jtdevs/LIDAR/user manual/img/IMG_20170323_115832.jpg

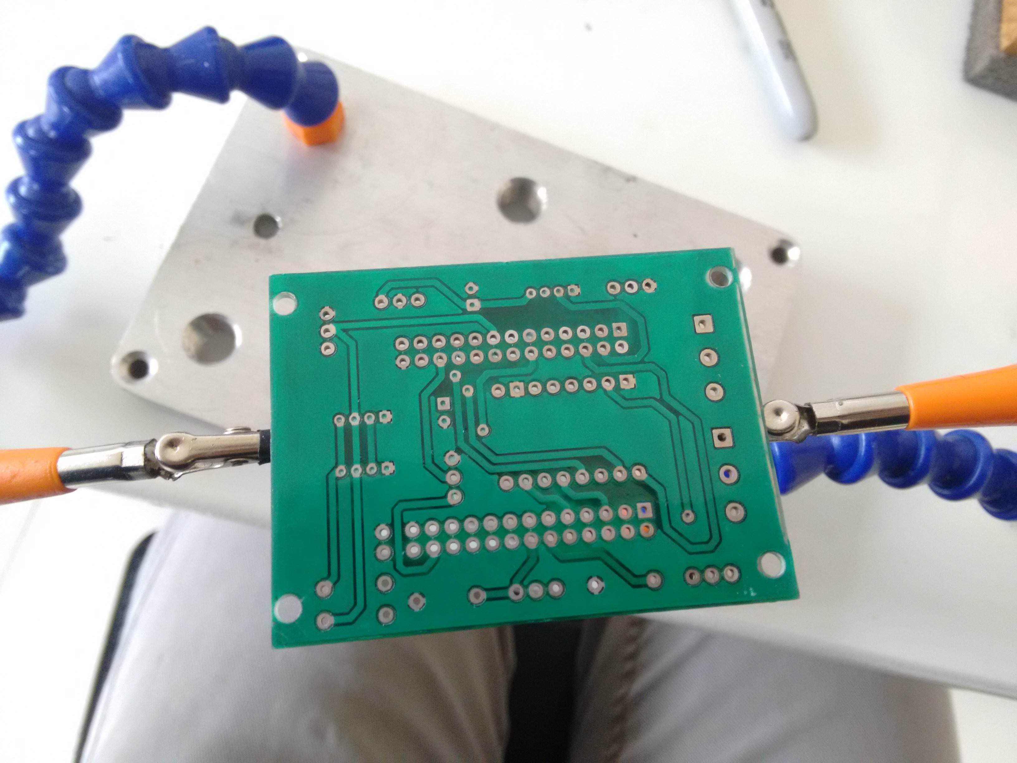
user manual/img/IMG_20170323_115832.jpg
