jtdevs/LIDAR/user manual/img/mainboard.jpg

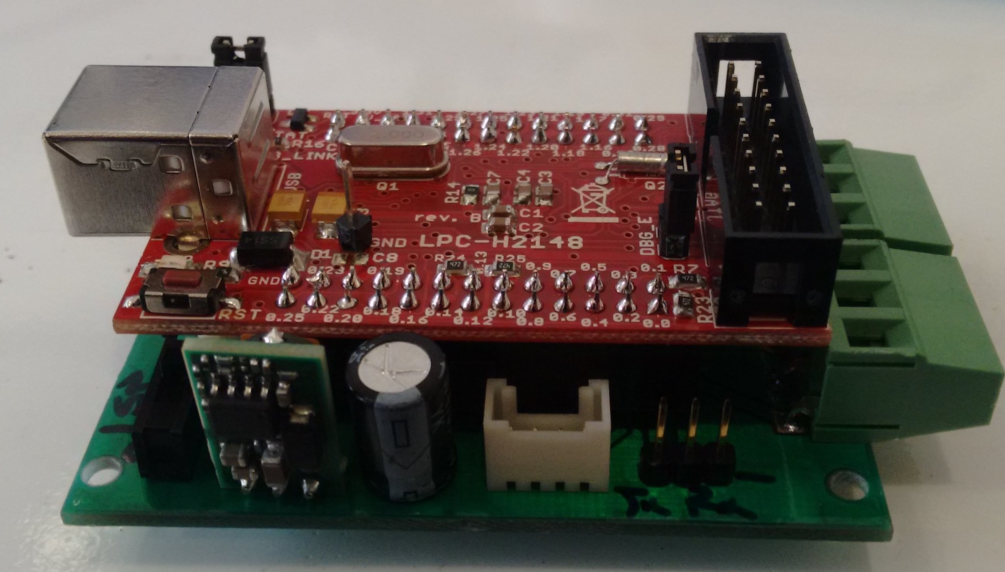
user manual/img/mainboard.jpg
