jtdevs/LIDAR/docs/dev board/schematics.pdf

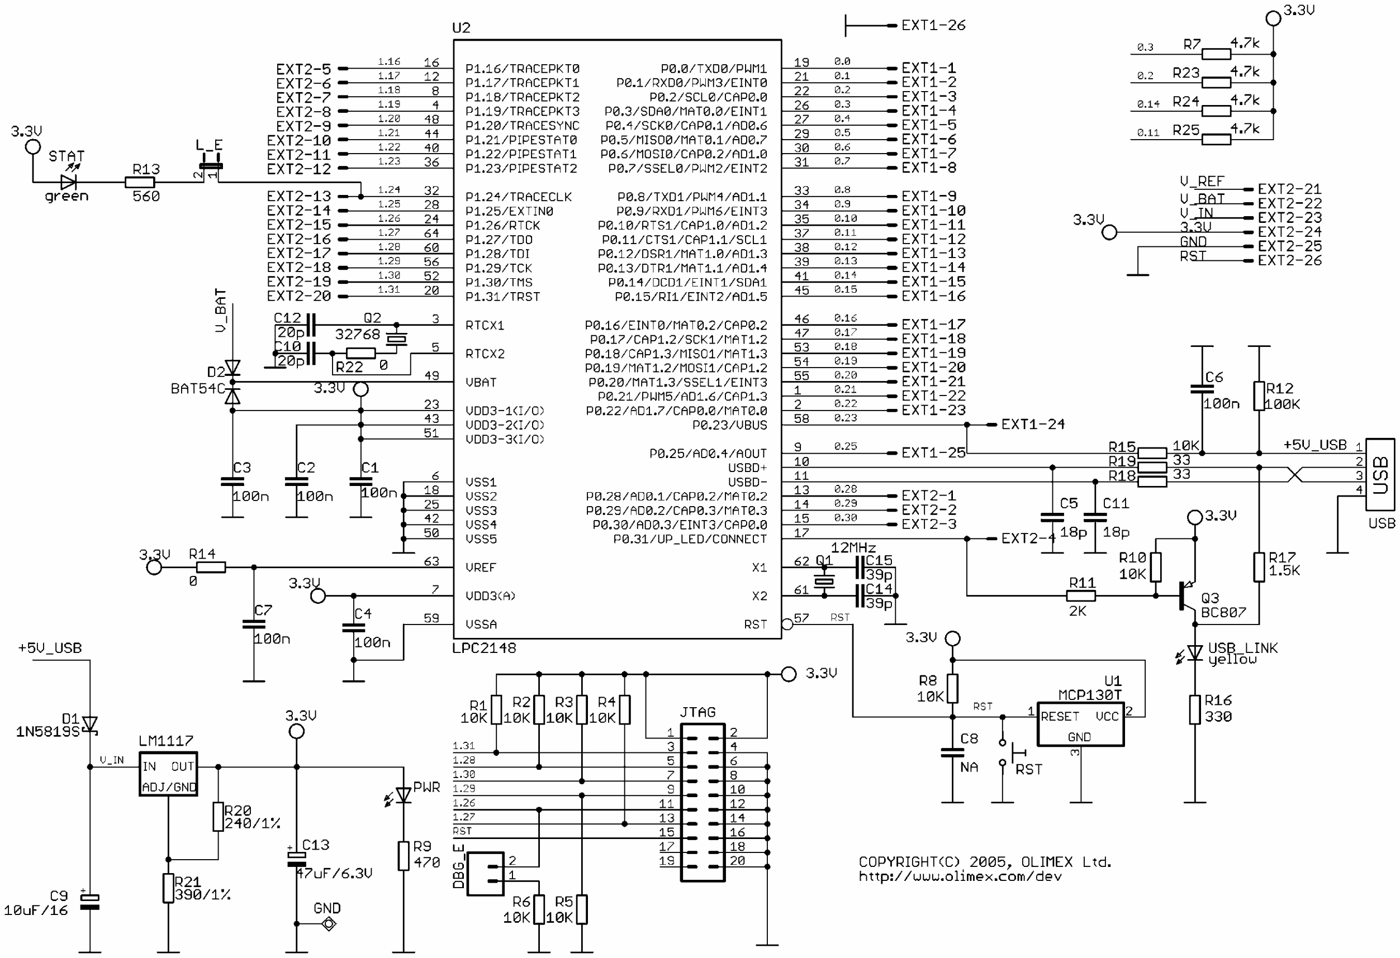
[picture p3: figure]
