jtdevs/LIDAR/pcb/snaps/bot.png

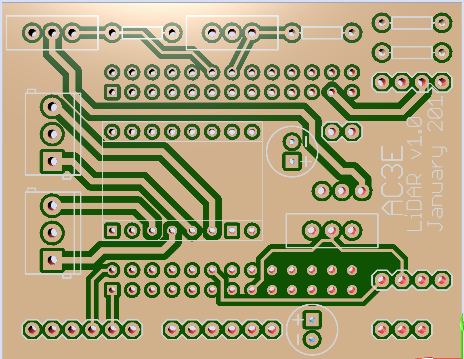
pcb/snaps/bot.png
