jtdevs/LIDAR/pcb/snaps/bot_final.png

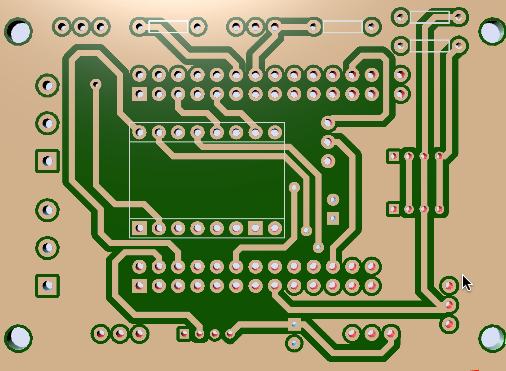
pcb/snaps/bot_final.png
