jtdevs/LIDAR/pcb/snaps/IMG_20170323_115810.jpg

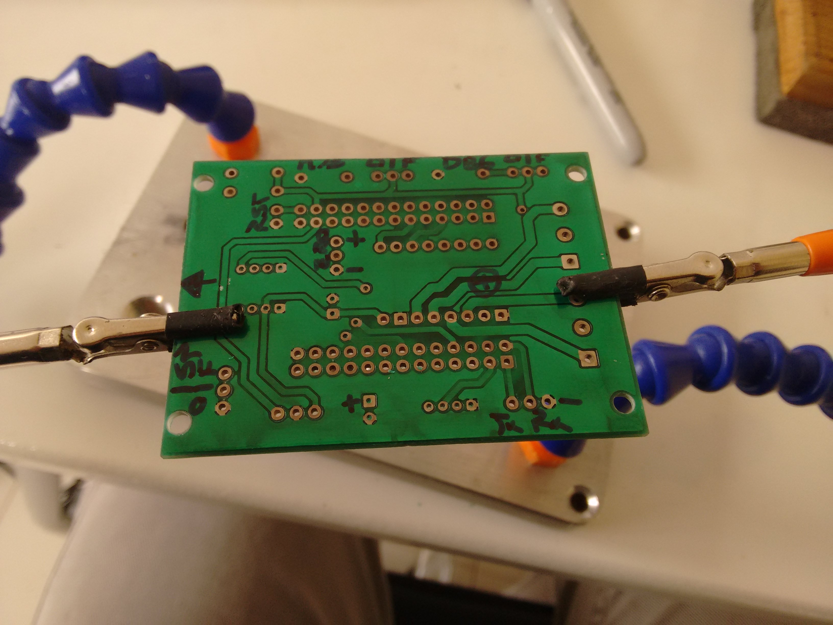
pcb/snaps/IMG_20170323_115810.jpg
