jtdevs/LIDAR/pcb/snaps/IMG_20170323_124859.jpg

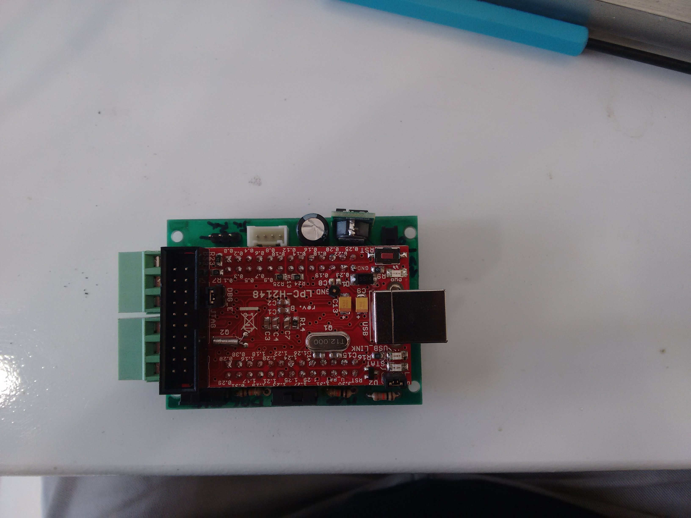
pcb/snaps/IMG_20170323_124859.jpg
