jtdevs/LIDAR/pcb/snaps/IMG_20170323_124909.jpg

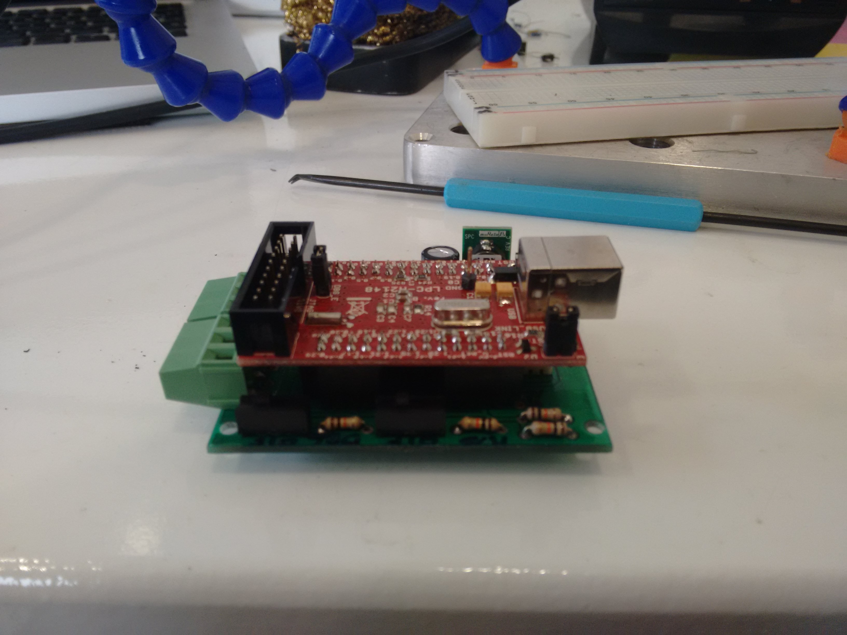
pcb/snaps/IMG_20170323_124909.jpg
