jtdevs/LIDAR/pcb/snaps/IMG_20170323_124930.jpg

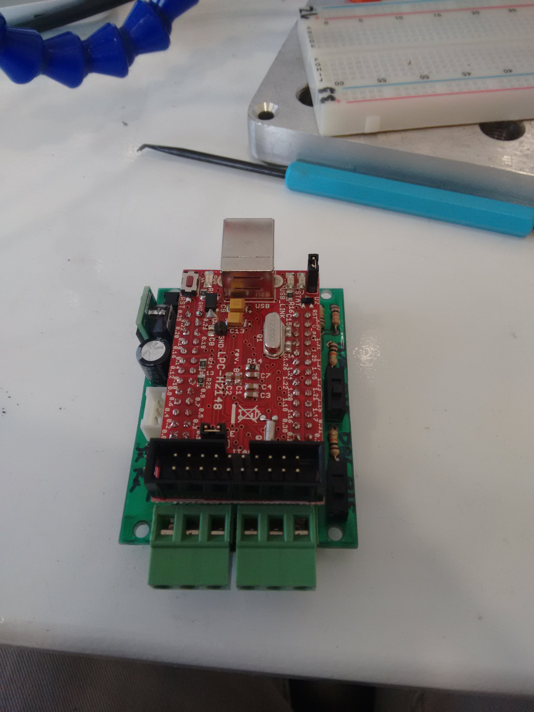
pcb/snaps/IMG_20170323_124930.jpg
