jtdevs/LIDAR/pcb/snaps/IMG_20170323_124938.jpg

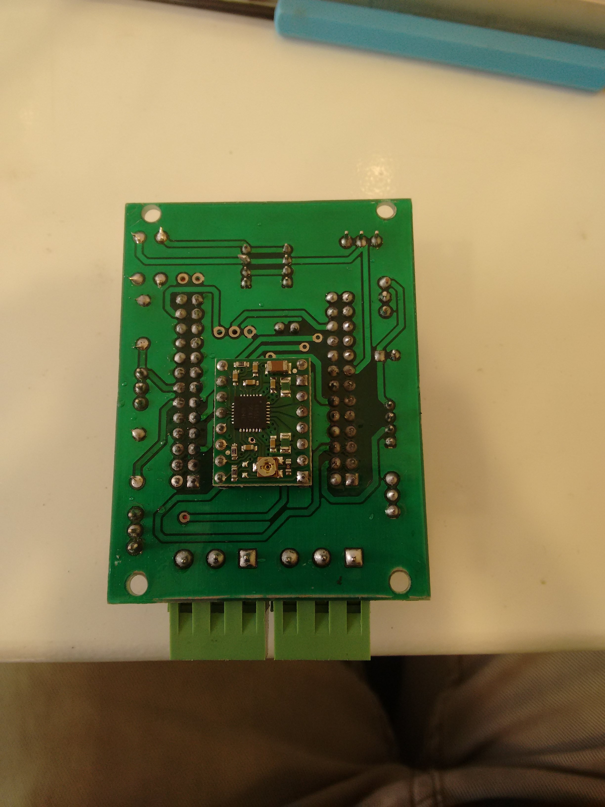
pcb/snaps/IMG_20170323_124938.jpg
