jtdevs/LIDAR/pcb/snaps/IMG_20170323_125006.jpg

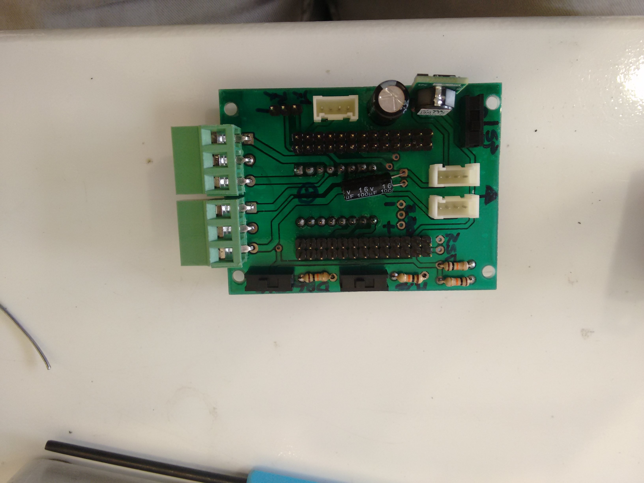
pcb/snaps/IMG_20170323_125006.jpg
