jtdevs/LIDAR/pcb/snaps/pcb.png

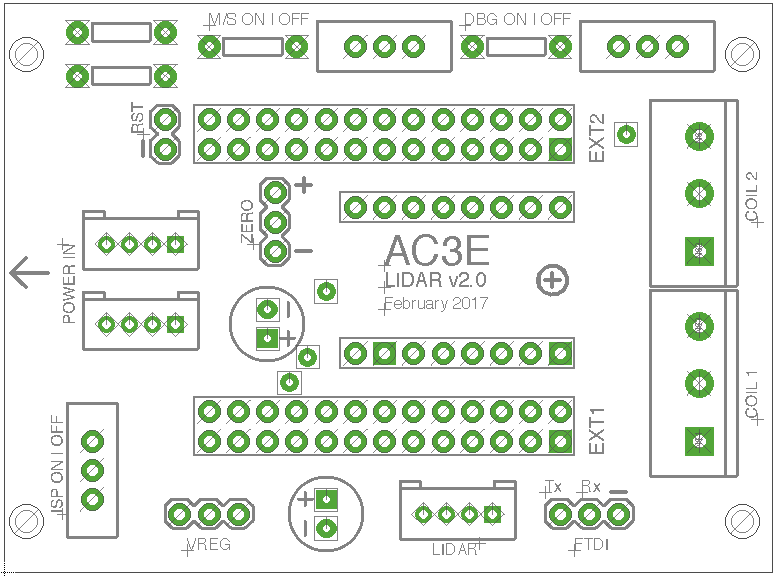
pcb/snaps/pcb.png
