jtdevs/LIDAR/pcb/snaps/schematic.png

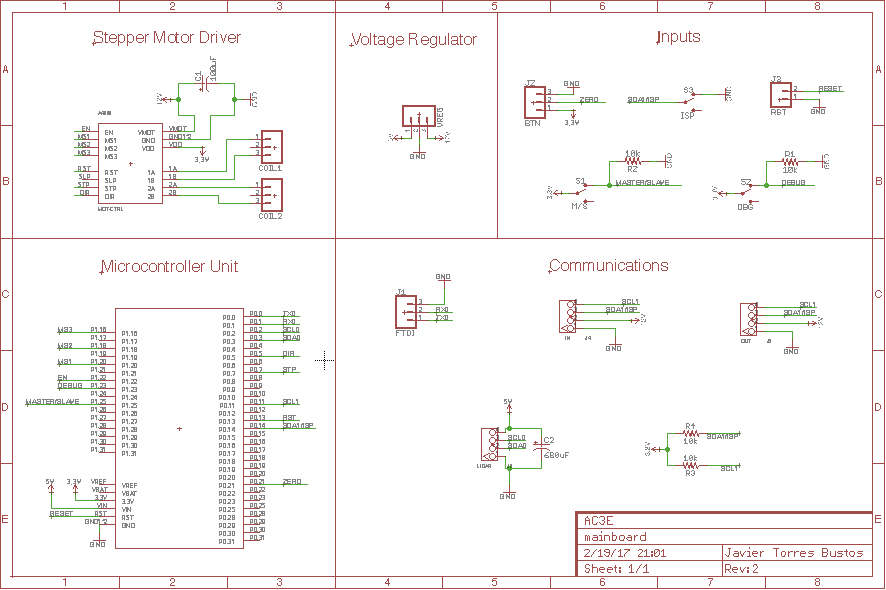
pcb/snaps/schematic.png
