jtdevs/LIDAR/pcb/snaps/top.png

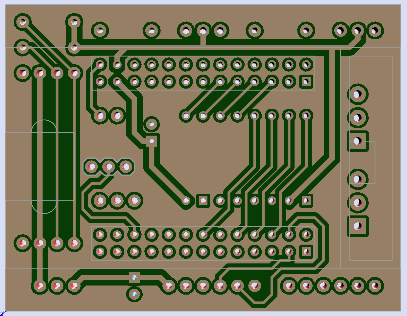
pcb/snaps/top.png
