jtdevs/LIDAR/pcb/snaps/top_final.png

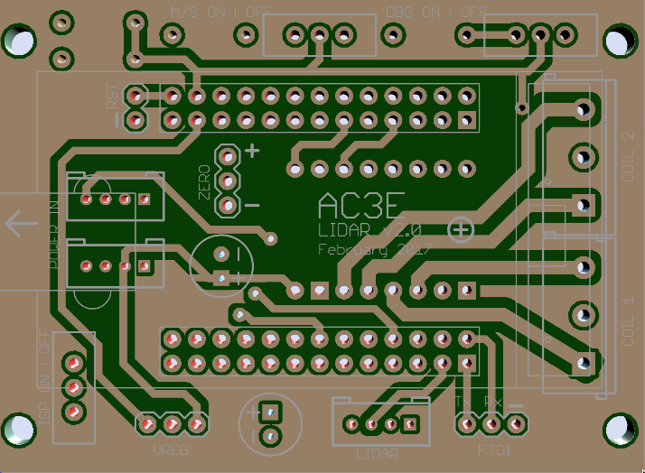
pcb/snaps/top_final.png
