jtdevs/LIDAR/snaps/100.png

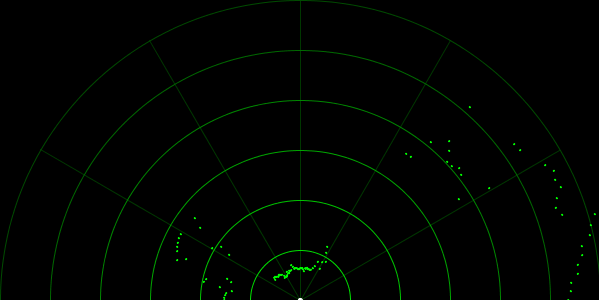
snaps/100.png
