jtdevs/LIDAR/snaps/200.png

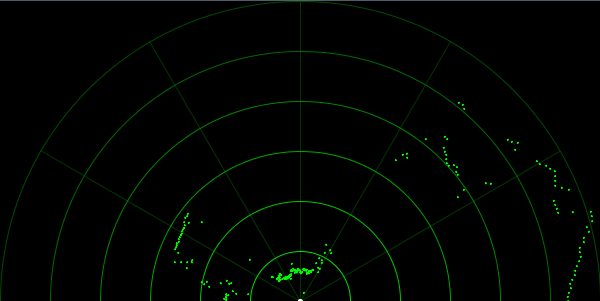
snaps/200.png
