jtdevs/LIDAR/snaps/400.png

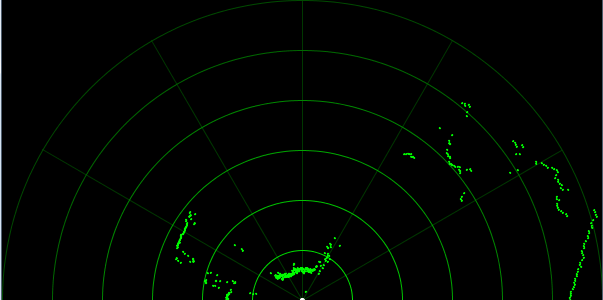
snaps/400.png
