jtdevs/LIDAR/snaps/back_cover_1.png

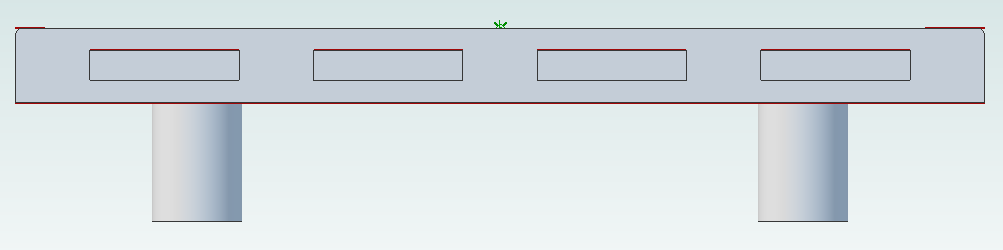
snaps/back_cover_1.png
