jtdevs/LIDAR/snaps/back_cover_3.png

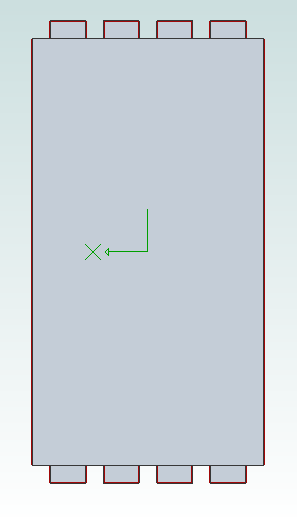
snaps/back_cover_3.png
