jtdevs/LIDAR/snaps/back_cover_4.png

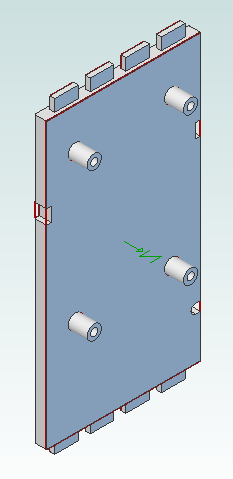
snaps/back_cover_4.png
