jtdevs/LIDAR/snaps/bracket_1.png

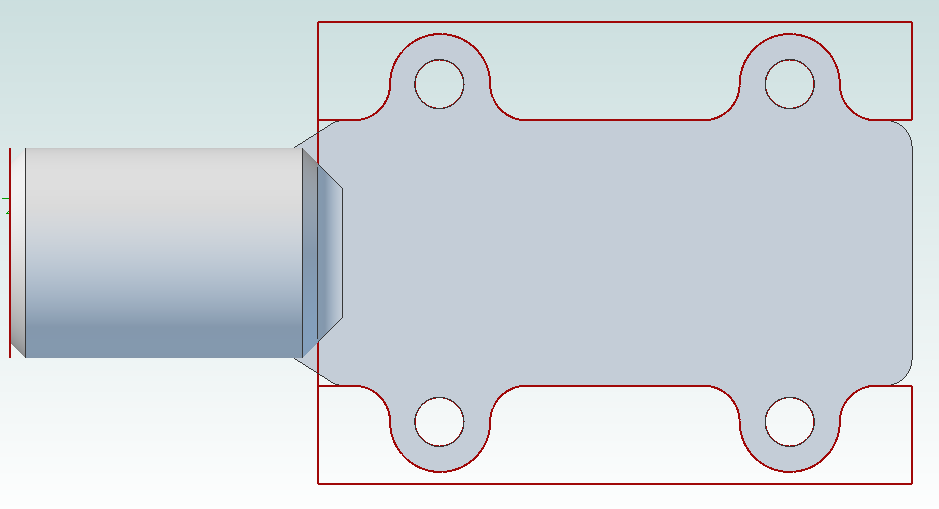
snaps/bracket_1.png
