jtdevs/LIDAR/snaps/bracket_2.png

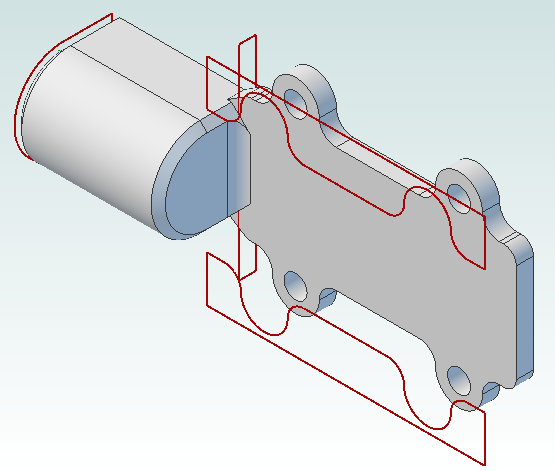
snaps/bracket_2.png
