jtdevs/LIDAR/snaps/enclosure_1.png

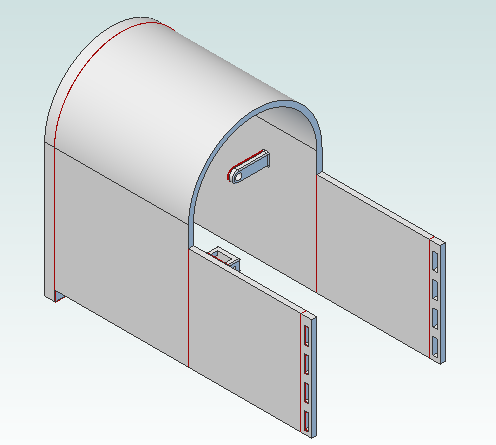
snaps/enclosure_1.png
