jtdevs/LIDAR/snaps/enclosure_2.png

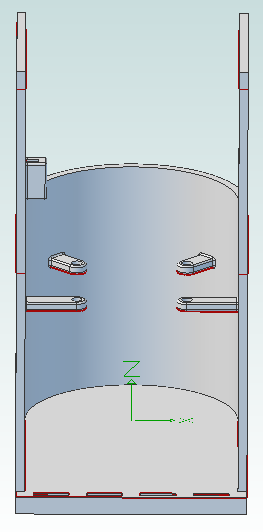
snaps/enclosure_2.png
