jtdevs/LIDAR/snaps/enclosure_3.png

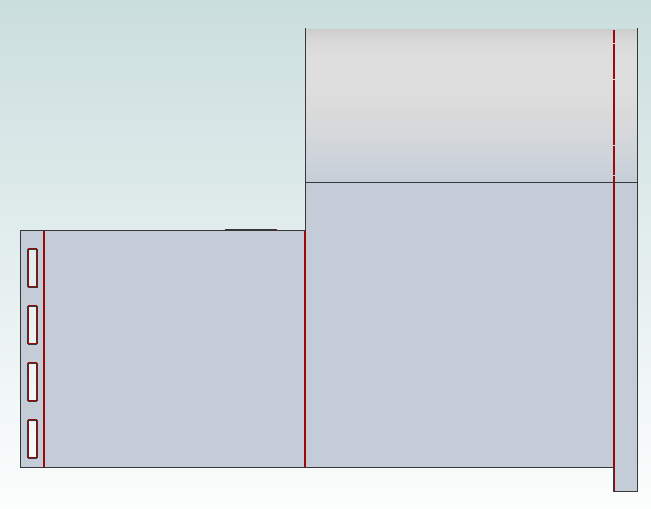
snaps/enclosure_3.png
