jtdevs/LIDAR/snaps/example reading.png

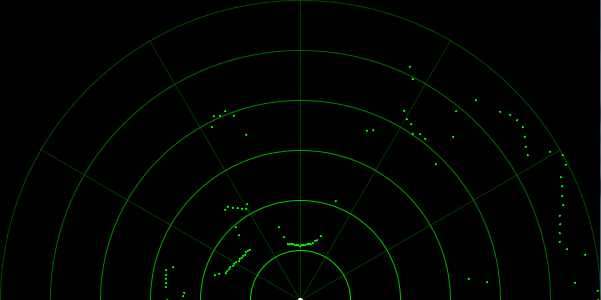
snaps/example reading.png
