jtdevs/LIDAR/snaps/example_reading_2.png

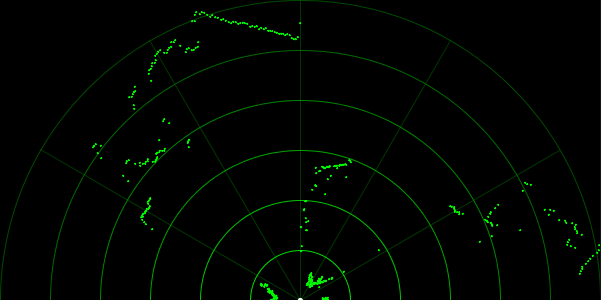
snaps/example_reading_2.png
