jtdevs/LIDAR/snaps/top_plat.png

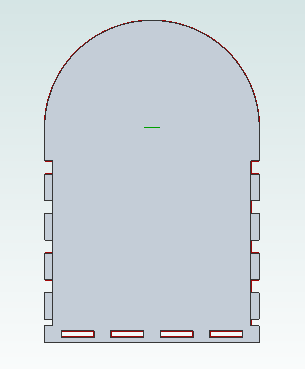
snaps/top_plat.png
