jtdevs/LIDAR/3d_models/bot_plate.stl

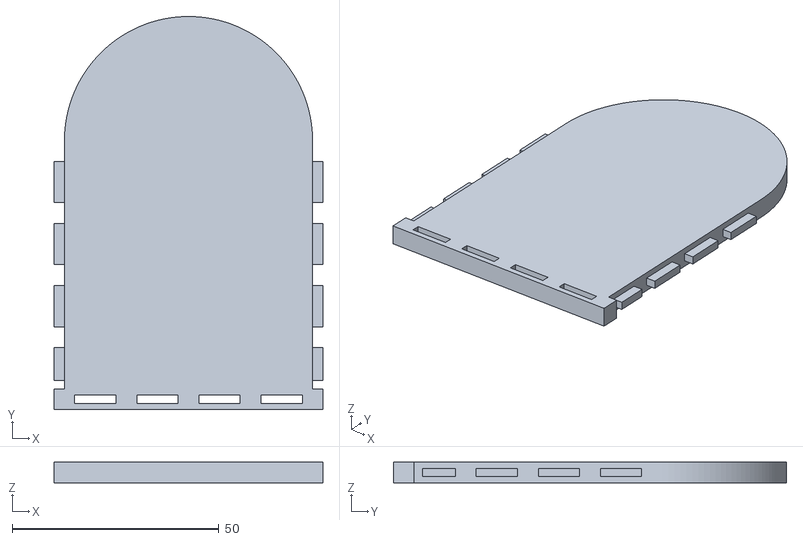
[picture p30: CAD file, 2017-07-31]
3d_models/bot_plate.stl
65.0 x 95.0 x 5.00
