jtdevs/LIDAR/3d_models/top_plate.stl

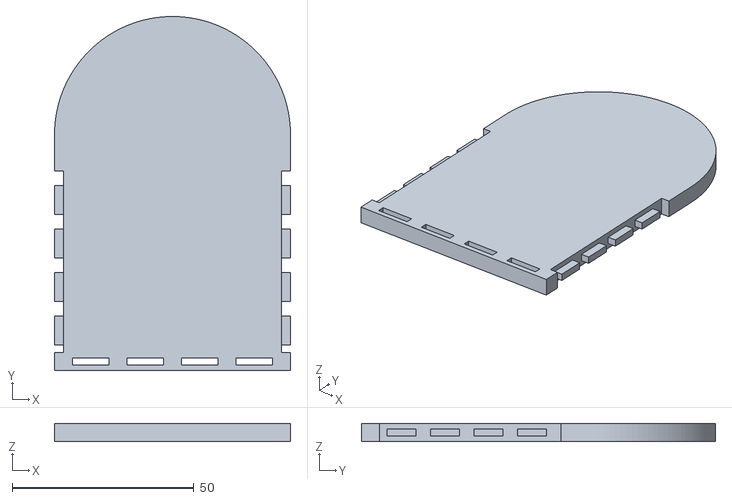
[picture p31: CAD file, 2017-07-31]
3d_models/top_plate.stl
65.0 x 97.5 x 5.00
