jtdevs/LIDAR/3d_models/back_cover.stl

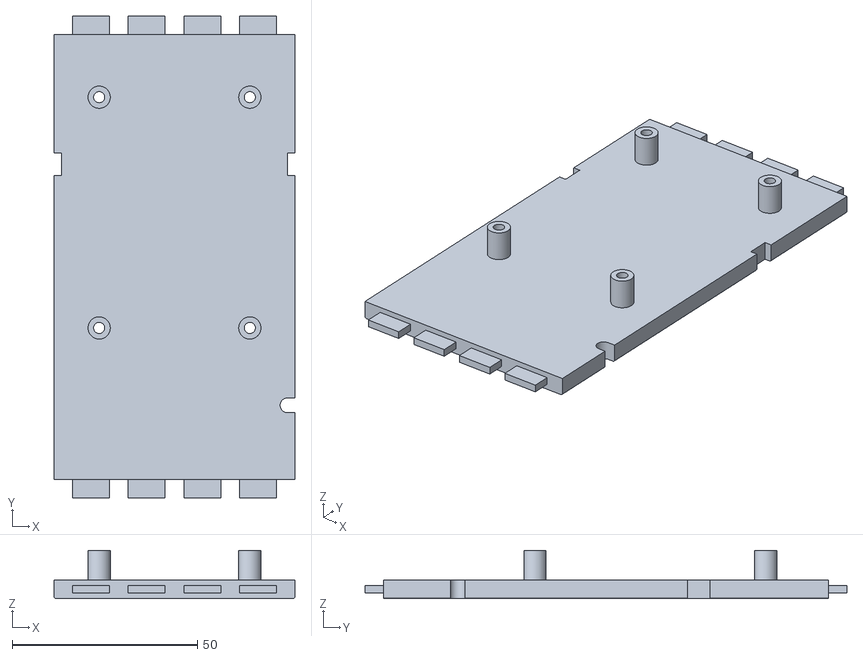
[picture p32: CAD file, 2017-07-31]
3d_models/back_cover.stl
65.0 x 130.0 x 13.0
