jtdevs/LIDAR/3d_models/bracket.stl

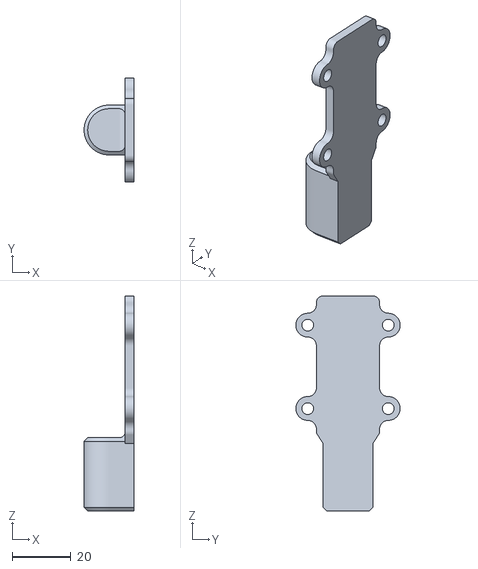
[picture p33: CAD file, 2017-07-31]
3d_models/bracket.stl
17.0 x 35.6 x 73.3
