jtdevs/LIDAR/user manual/img/grove cable.jpg

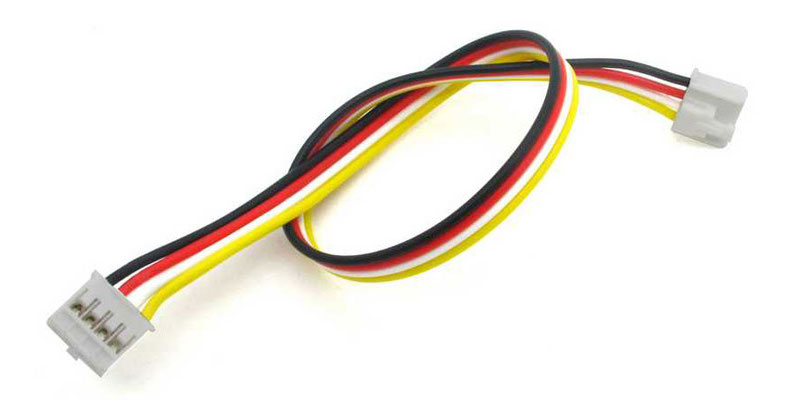
user manual/img/grove cable.jpg
