jtdevs/LIDAR/user manual/img/IMG_20170323_150202.jpg

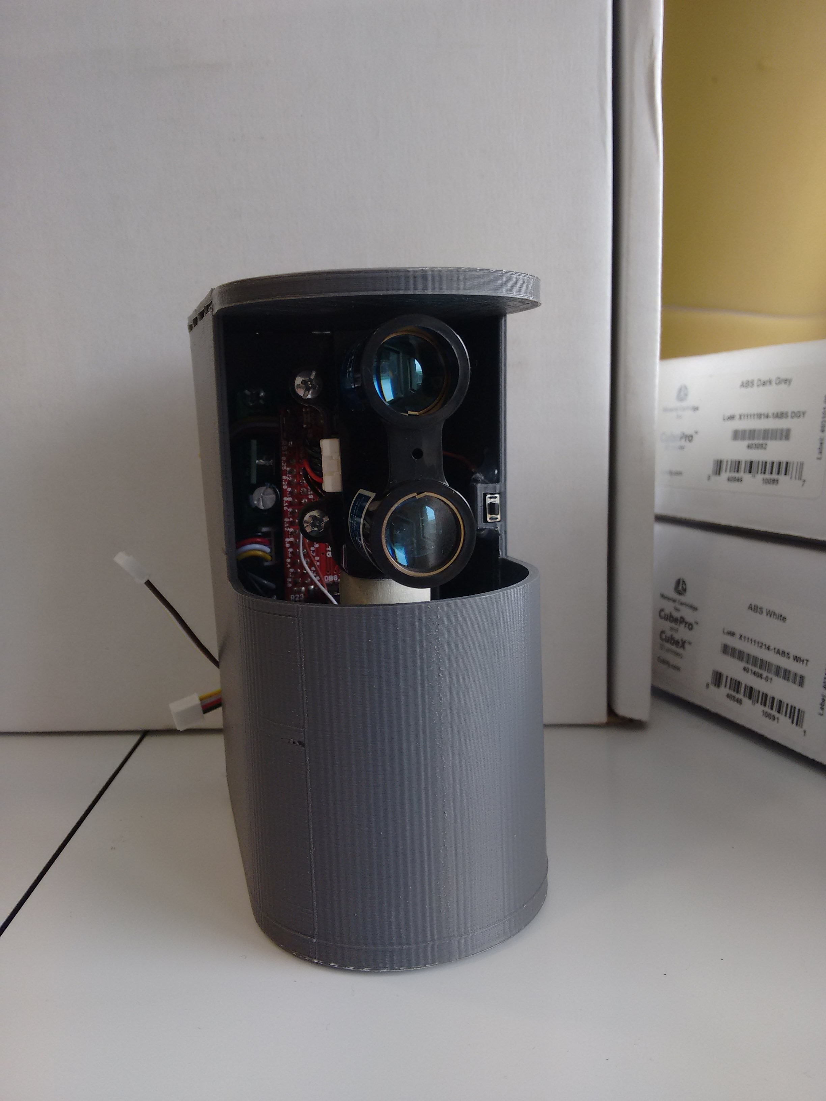
user manual/img/IMG_20170323_150202.jpg
