jtdevs/LIDAR/user manual/img/jtlidar.jpeg

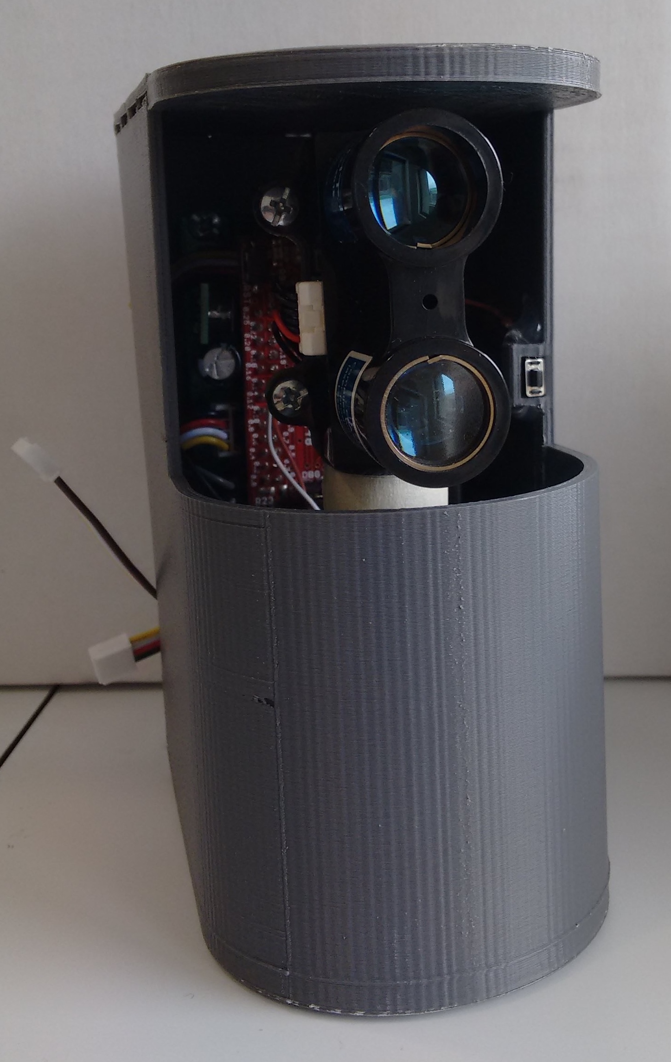
user manual/img/jtlidar.jpeg
