jtdevs/LIDAR/user manual/img/laser_parameters.png

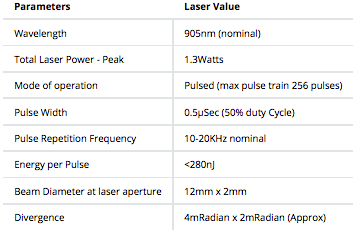
user manual/img/laser_parameters.png
