jtdevs/LIDAR/user manual/img/lasersafety.png

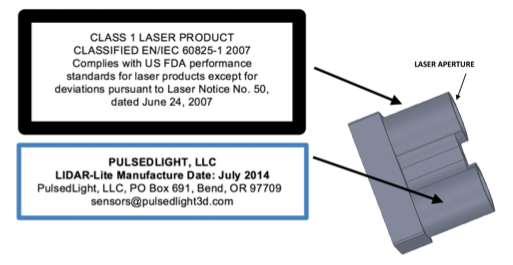
user manual/img/lasersafety.png
