jtdevs/LIDAR/user manual/img/lidar.jpg

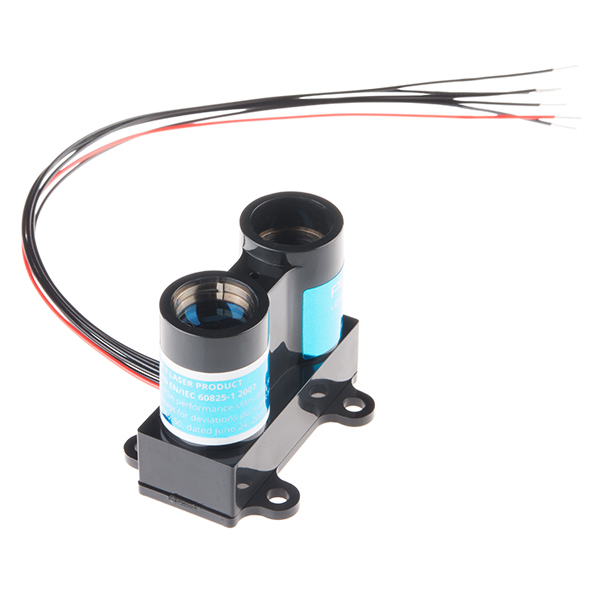
user manual/img/lidar.jpg
