jtdevs/LIDAR/user manual/img/stepper.jpg

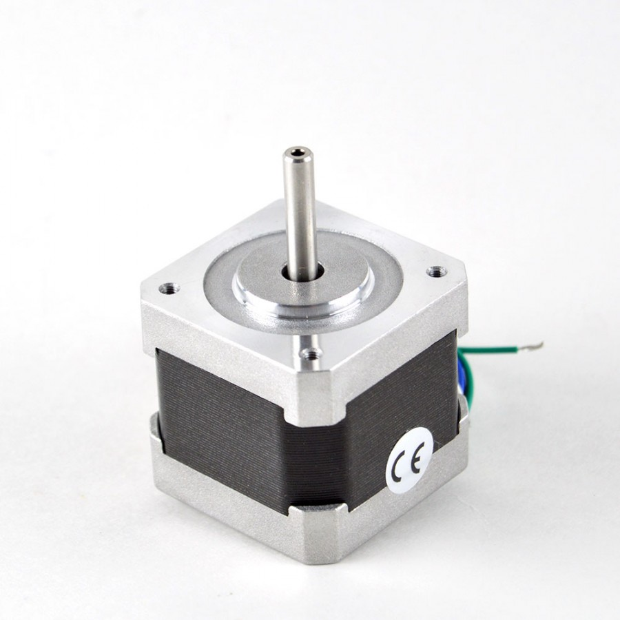
user manual/img/stepper.jpg
