jtdevs/LIDAR/user manual/img/tabla.png

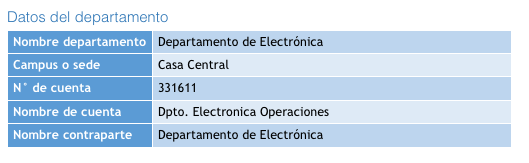
user manual/img/tabla.png
