jtdevs/LIDAR/pcb/eagle/mainboard.brd

## EAGLE design pcb/eagle/mainboard.brd (2017-07-31)

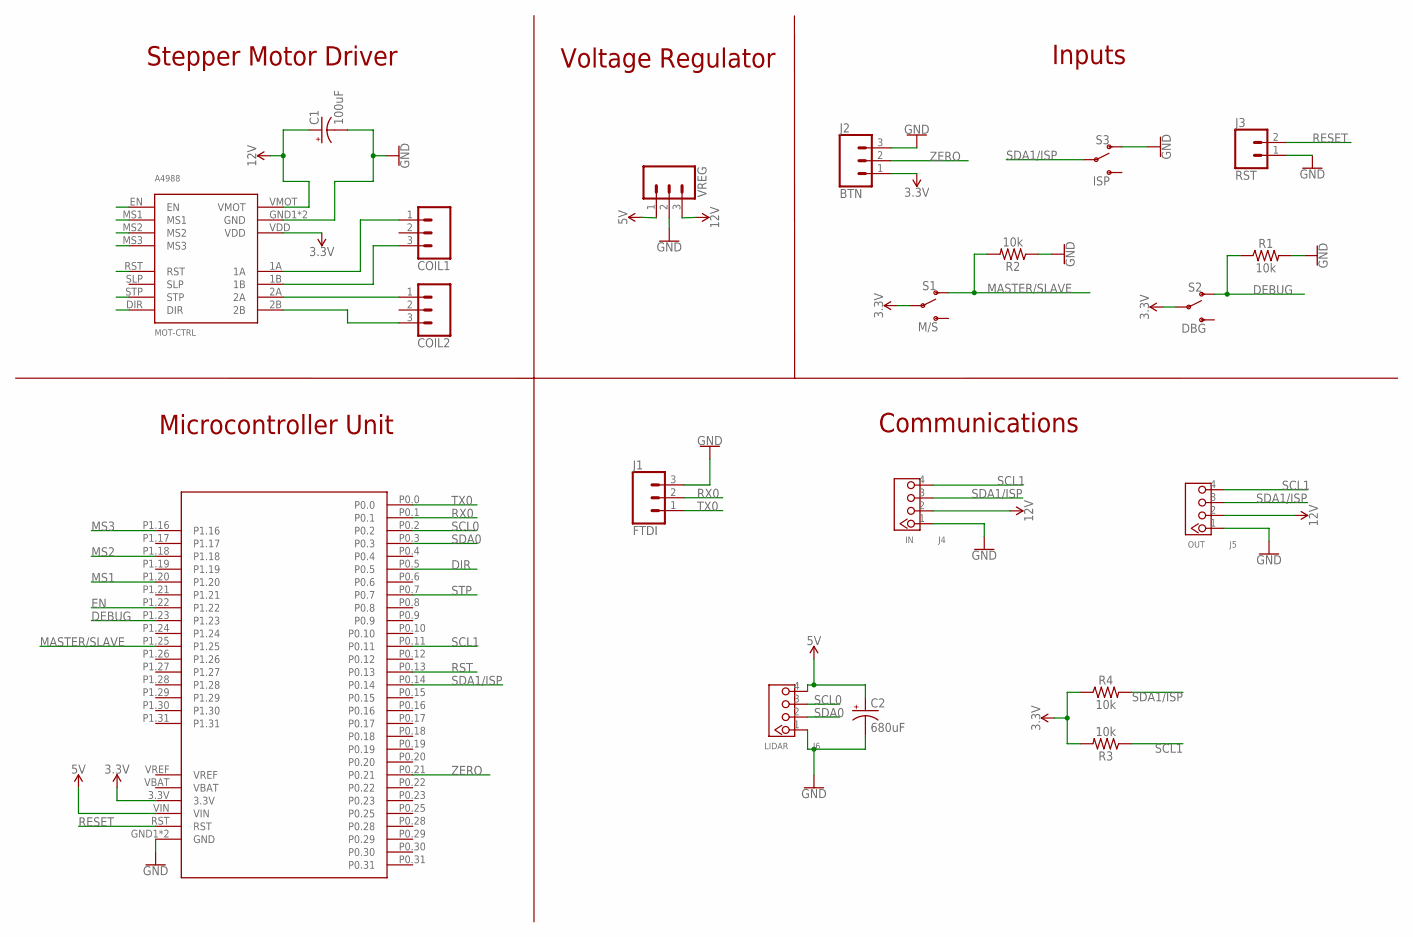
[picture p42: schematic mainboard.sch]

Parts:
A4988: MOT-CTRL; POLOLU-6X8
C1: 100uF; CPOL-RADIAL-2.5MM-6.5MM
C2: 680uF; CPOL-RADIAL-2.5MM-6.5MM
COIL1, COIL2: CONN_03-SCREW-5MM; SCREWTERMINAL-5MM-3
J1: FTDI; 1X03
J2: BTN; 1X03
J3: RST; 1X02
J4: IN; HW4-2.0
J5: OUT; HW4-2.0
J6: LIDAR; HW4-2.0
LPC2148: MCU; LPC-H2148
R1, R2, R3, R4: 10k; AXIAL-0.3
S1: M/S; SWITCH_SPDT_PTH_11.6X4.0MM
S2: DBG; SWITCH_SPDT_PTH_11.6X4.0MM
S3: ISP; SWITCH_SPDT_PTH_11.6X4.0MM
VREG: CONN_03; 1X03

Connections:
3.3V: A4988.VDD, J2.1, LPC2148.3.3V, R3.P$2 (2), R4.P$1 (1), S1.2, S2.2
5V: C2.1 (+), J6.4, LPC2148.VIN, VREG.1
12V: A4988.VMOT, C1.1 (+), J4.2, J5.2, VREG.3
DEBUG: LPC2148.P1.23, R1.P$1 (1), S2.1 (O)
DIR: A4988.DIR, LPC2148.P0.5
EN: A4988.EN, LPC2148.P1.22
GND: A4988.GND1 (GND), A4988.GND2 (GND), C1.2 (-), C2.2 (-), J1.3, J2.3, J3.1, J4.1, J5.1, J6.1, LPC2148.GND1 (GND), LPC2148.GND2 (GND), R1.P$2 (2), R2.P$1 (1), S3.1 (O), VREG.2
MASTER/SLAVE: LPC2148.P1.25, R2.P$2 (2), S1.1 (O)
MS1: A4988.MS1, LPC2148.P1.20
MS2: A4988.MS2, LPC2148.P1.18
MS3: A4988.MS3, LPC2148.P1.16
unnamed: A4988.2B, COIL2.3
unnamed: A4988.2A, COIL2.1
unnamed: A4988.1B, COIL1.3
unnamed: A4988.1A, COIL1.1
RESET: J3.2, LPC2148.RST
RST: A4988.RST, LPC2148.P0.13
RX0: J1.2, LPC2148.P0.1
SCL0: J6.3, LPC2148.P0.2
SCL1: J4.4, J5.4, LPC2148.P0.11, R3.P$1 (1)
SDA0: J6.2, LPC2148.P0.3
SDA1/ISP: J4.3, J5.3, LPC2148.P0.14, R4.P$2 (2), S3.2
STP: A4988.STP, LPC2148.P0.7
TX0: J1.1, LPC2148.P0.0
ZERO: J2.2, LPC2148.P0.21

Notes on the sheet:
Stepper Motor Driver
Microcontroller Unit
Inputs
Communications
Voltage Regulator

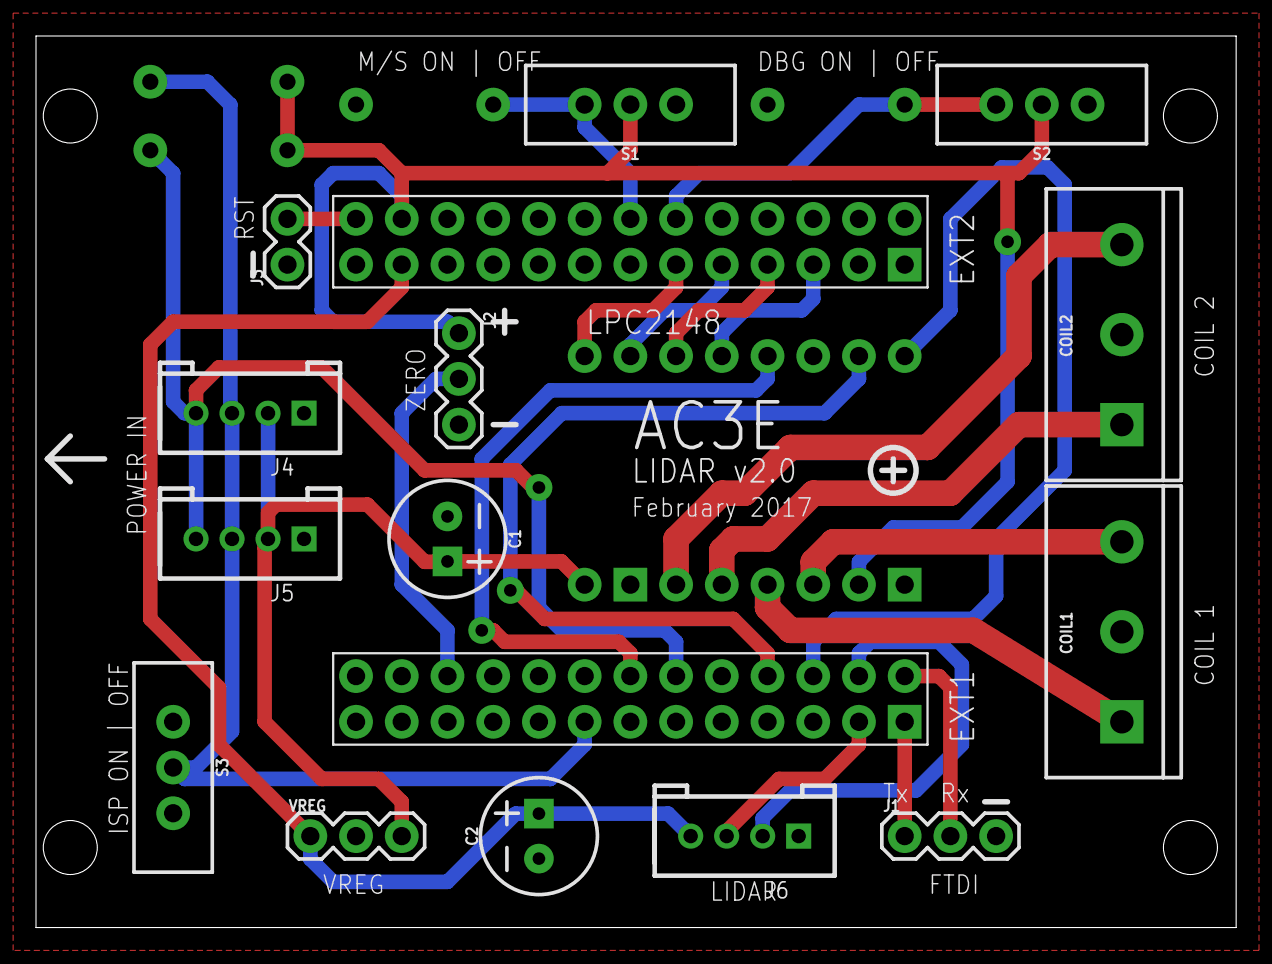
[picture p43: board mainboard.brd from above]

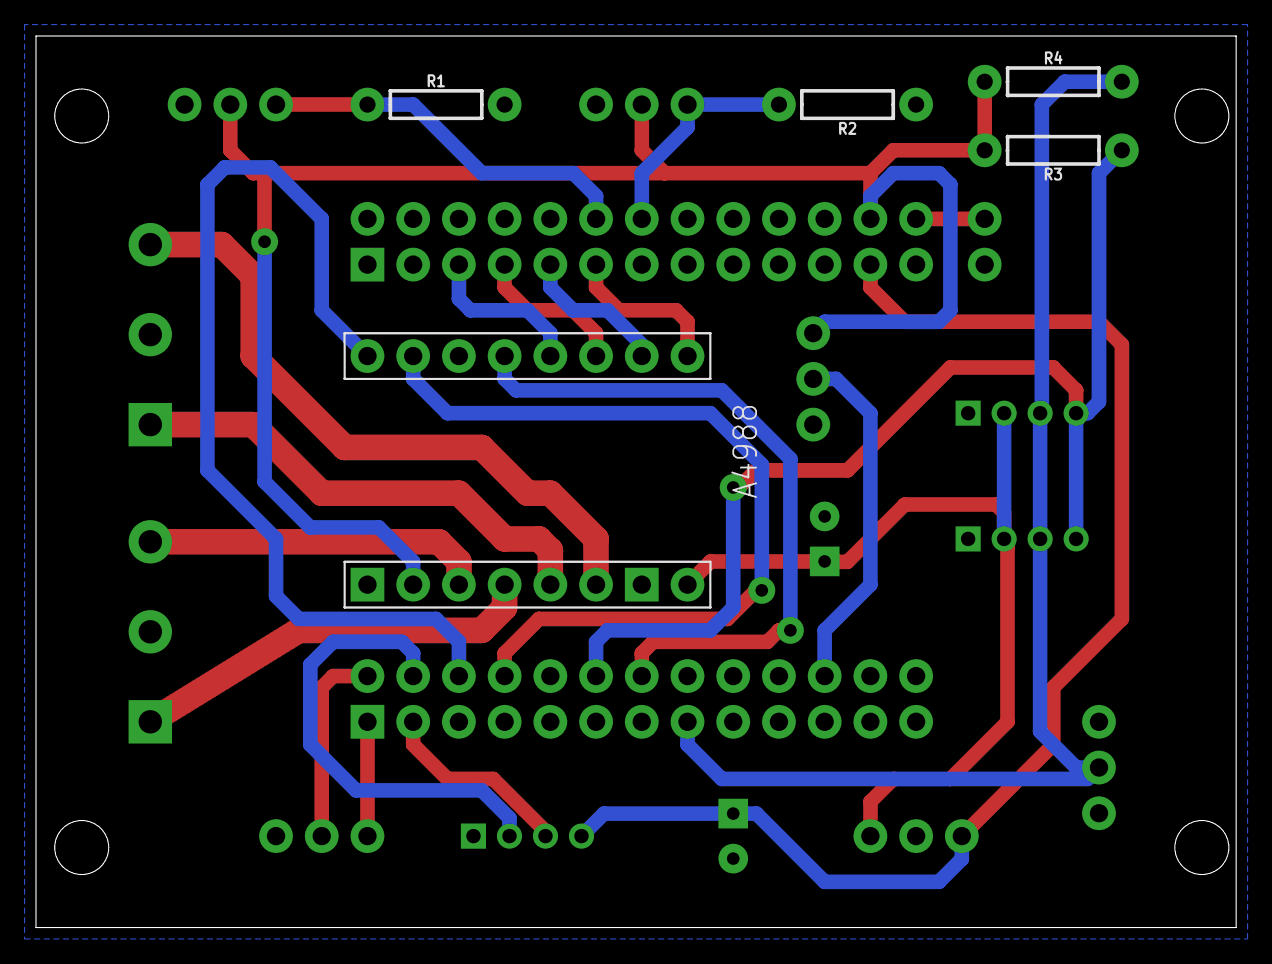
[picture p44: board mainboard.brd from below]

Board: 2 copper layers, 66.7 x 49.5 mm, 20 parts (5 on the bottom side), 25 nets.
