jtdevs/LIDAR/main.c

#include "LPC214x.H"
#include "LIDAR.h"
#include "DATATYPES.h"
#include "I2C0.h"
#include "I2C1.h"
#include "TMR.h"
#include "UART.h"
#define UART TRUE
#define I2C FALSE

BOOL continuous = FALSE;
int main(void)
{
	//variables
	uint8 LSBmap[401];//assume the worst case and allocate space for 1/16th steps
	uint8 MSBmap[401];
	uint8 input = 0;
	uint8 *pinput = &input;
	uint8 step_divider = 1;
	BOOL debug, ms;
	//system control inputs
	init_inputs();
	debug = dbg_stat();
	//debug = FALSE;
	//ms = FALSE;
	ms = ms_stat();
	//User feedback led
	Init_LED();
	LED_ON();
	//timing related
	init_clock(); //set the clock to 60MHz
	init_timer(); // Initialize Timer
	//Communications
	InitUART0(FALSE); // Initialize UART0
	I2C0_init(); // Initialize I2C0
	//LIDAR and motor initialization
	motor_init();
	sensorInit();

	LED_OFF();

	if(ms == TRUE)
	{
		I2C1_init(0x02);
		LED_ON();
		delayMicros(500000);//half a second
		LED_OFF();
		delayMicros(500000);//half a second
		LED_ON();
		delayMicros(500000);//half a second
		LED_OFF();
		while(TRUE)
		{
			//input = U0Read();
			input = UART_buff;
			switch(input)
			{
				case 0x00:
					if(continuous)
						updateRange(LSBmap, MSBmap, step_divider);
					break;

				case 0x01:
					UART_buff = 0;
					change_step(1);
					I2C1_byteTx(0x00, 0x00);
					step_divider = 1;
					break;

				case 0x02:
					UART_buff = 0;
					change_step(2);
					I2C1_byteTx(0x00, 0x01);
					step_divider = 2;
					break;

				case 0x03:
					UART_buff = 0;
					change_step(4);
					I2C1_byteTx(0x00, 0x02);
					step_divider = 4;
					break;

				case 0x04:
					UART_buff = 0;
					continuous = !continuous;
					break;

				case 0x05:
					UART_buff = 0;
					if(!continuous)
						updateRange(LSBmap, MSBmap, step_divider);
					sendMap(LSBmap, MSBmap, step_divider, UART);
					break;
					
				default:
					UART_buff = 0;
					external_request(LSBmap, MSBmap, step_divider, input-5);
					sendMap(LSBmap, MSBmap, step_divider, UART);
					break;
			}
		}
	}
	else
	{
		I2C1_init(0xA1);
		LED_ON();
		delayMicros(500000);//half a second
		LED_OFF();
		delayMicros(500000);//half a second
		LED_ON();
		delayMicros(500000);//half a second
		LED_OFF();
		delayMicros(500000);//half a second
		LED_ON();
		delayMicros(500000);//half a second
		LED_OFF();
		while(TRUE)
		{
			I2C1_byteRx(pinput);
			switch(input)
			{
				case 0x00:
					change_step(1);
					step_divider = 1;
					break;

				case 0x01:
					change_step(2);
					step_divider = 2;
					break;

				case 0x02:
					change_step(4);
					step_divider = 4;
					break;

				case 0x03:
					LED_ON();
					delayMicros(500000);//half a second
					LED_OFF();
					break;

				case 0x04:
					updateRange(LSBmap, MSBmap, step_divider);
					sendMap(LSBmap, MSBmap, step_divider, I2C);
					break;

				default:
					break;
			}
		}
	}
}
//Para efectos de prueba se dejaran las direcciones constantes por ahora.
