jtdevs/LIDAR/DATATYPES.h

#ifndef DATATYPES_H
#define DATATYPES_H

#ifndef NULL
#define NULL (0)	
#endif
#ifndef FALSE
#define FALSE (0)
#endif
#ifndef TRUE
#define TRUE (1)
#endif

/* ------------------------------------------------ Arm data types ------------------------------------------------ */
typedef unsigned char 		uint8; // 1 byte
typedef unsigned short int 	uint16; // 2 byte
typedef unsigned int 		uint32; // 4 byte
typedef char 		int8; // 1 byte
typedef short int 	int16; // 2 byte
typedef int 		int32; // 4 byte
typedef unsigned char	BOOL; // 1 byte

#endif
