jtdevs/LIDAR/(commit log)

2017-06-10 Iteration #1 after huge changes
    Errors found:
    pointer pinput not initialized was causing the system to be unresponsive to I2C commands. Everything else looks fine so far.
    Minor changes in code style.
    Interface code updated to match the changes in the system logic.
    [I2C1.c, LIDAR.c, interfaz.pde, main.c]
2017-06-10 Iteration #2 of 9/6/17
    Rookie mistake, wasn't sending the pointcloud after receiving it.... LOL
    [main.c]
2017-06-10 Bug found and detailed in main
    [LIDAR.c, main.c]
2017-07-14 UART interrupt routine
